jsavinc/arduino_micra_swc_interface/arduino_micra_swc_interface_schematic_schem.png

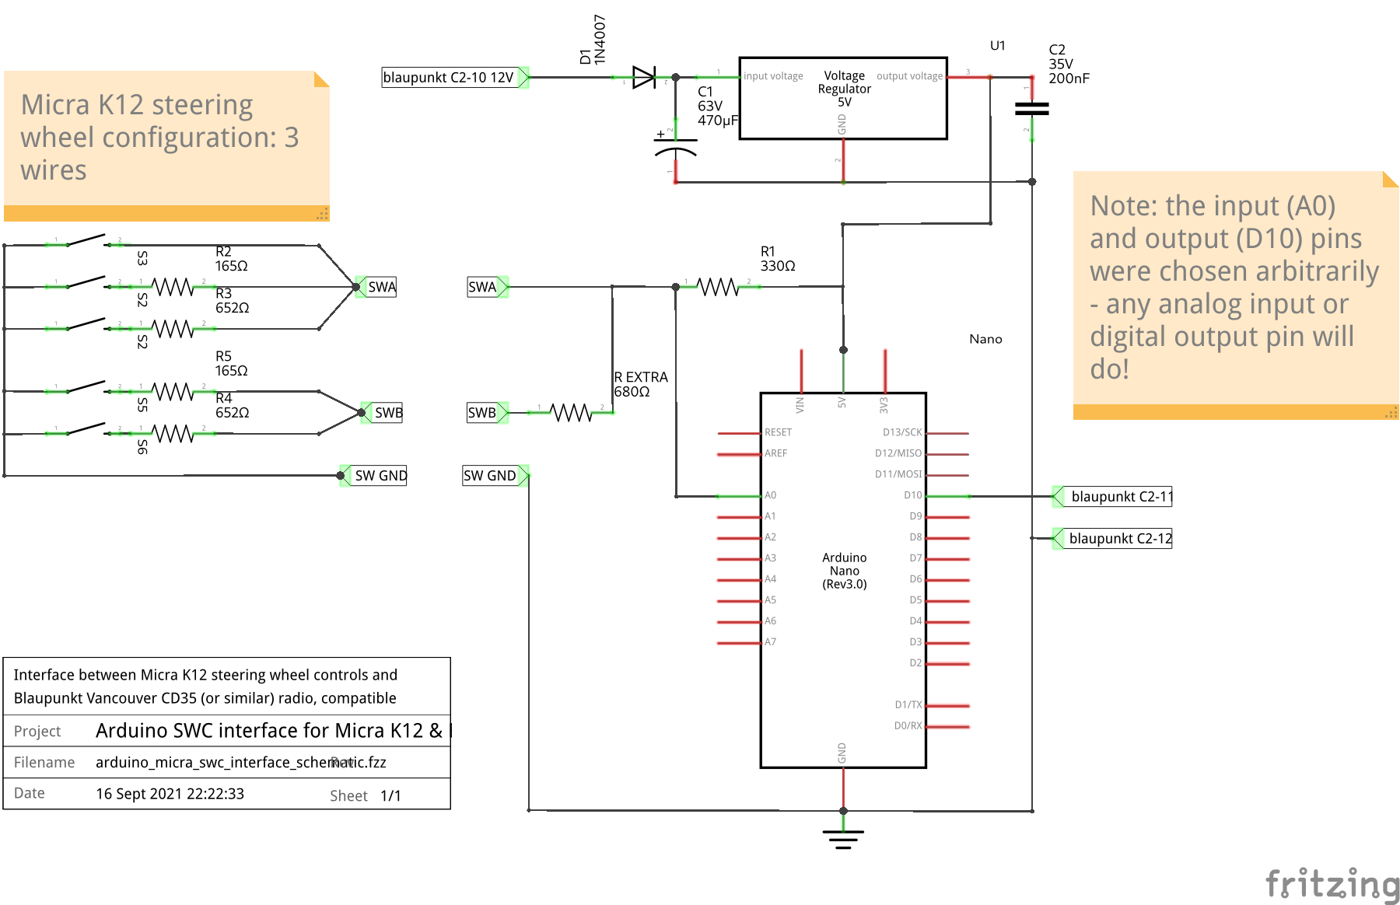
arduino_micra_swc_interface_schematic_schem.png
