jsavinc/arduino_micra_swc_interface/steering wheel - radio diagram micra k12.png

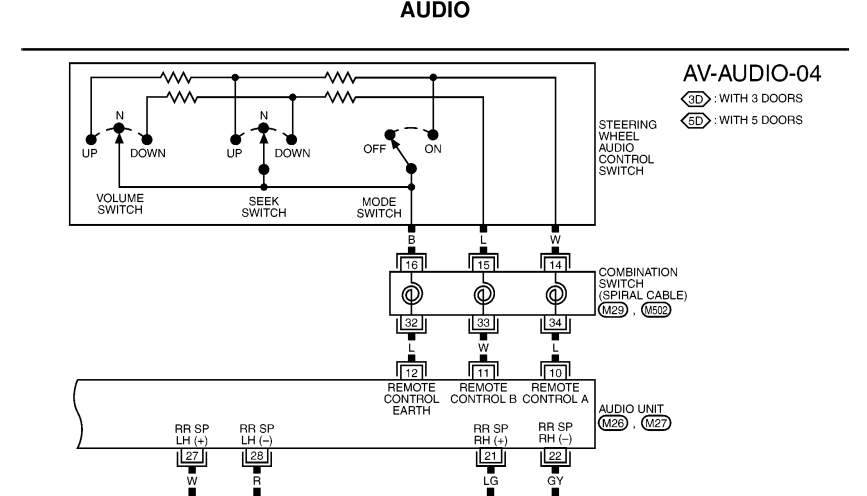
steering wheel - radio diagram micra k12.png
