jsavinc/arduino_micra_swc_interface/resistance_plot_extra_resistor_A.pdf

0 | 50 | 100 | 150

0

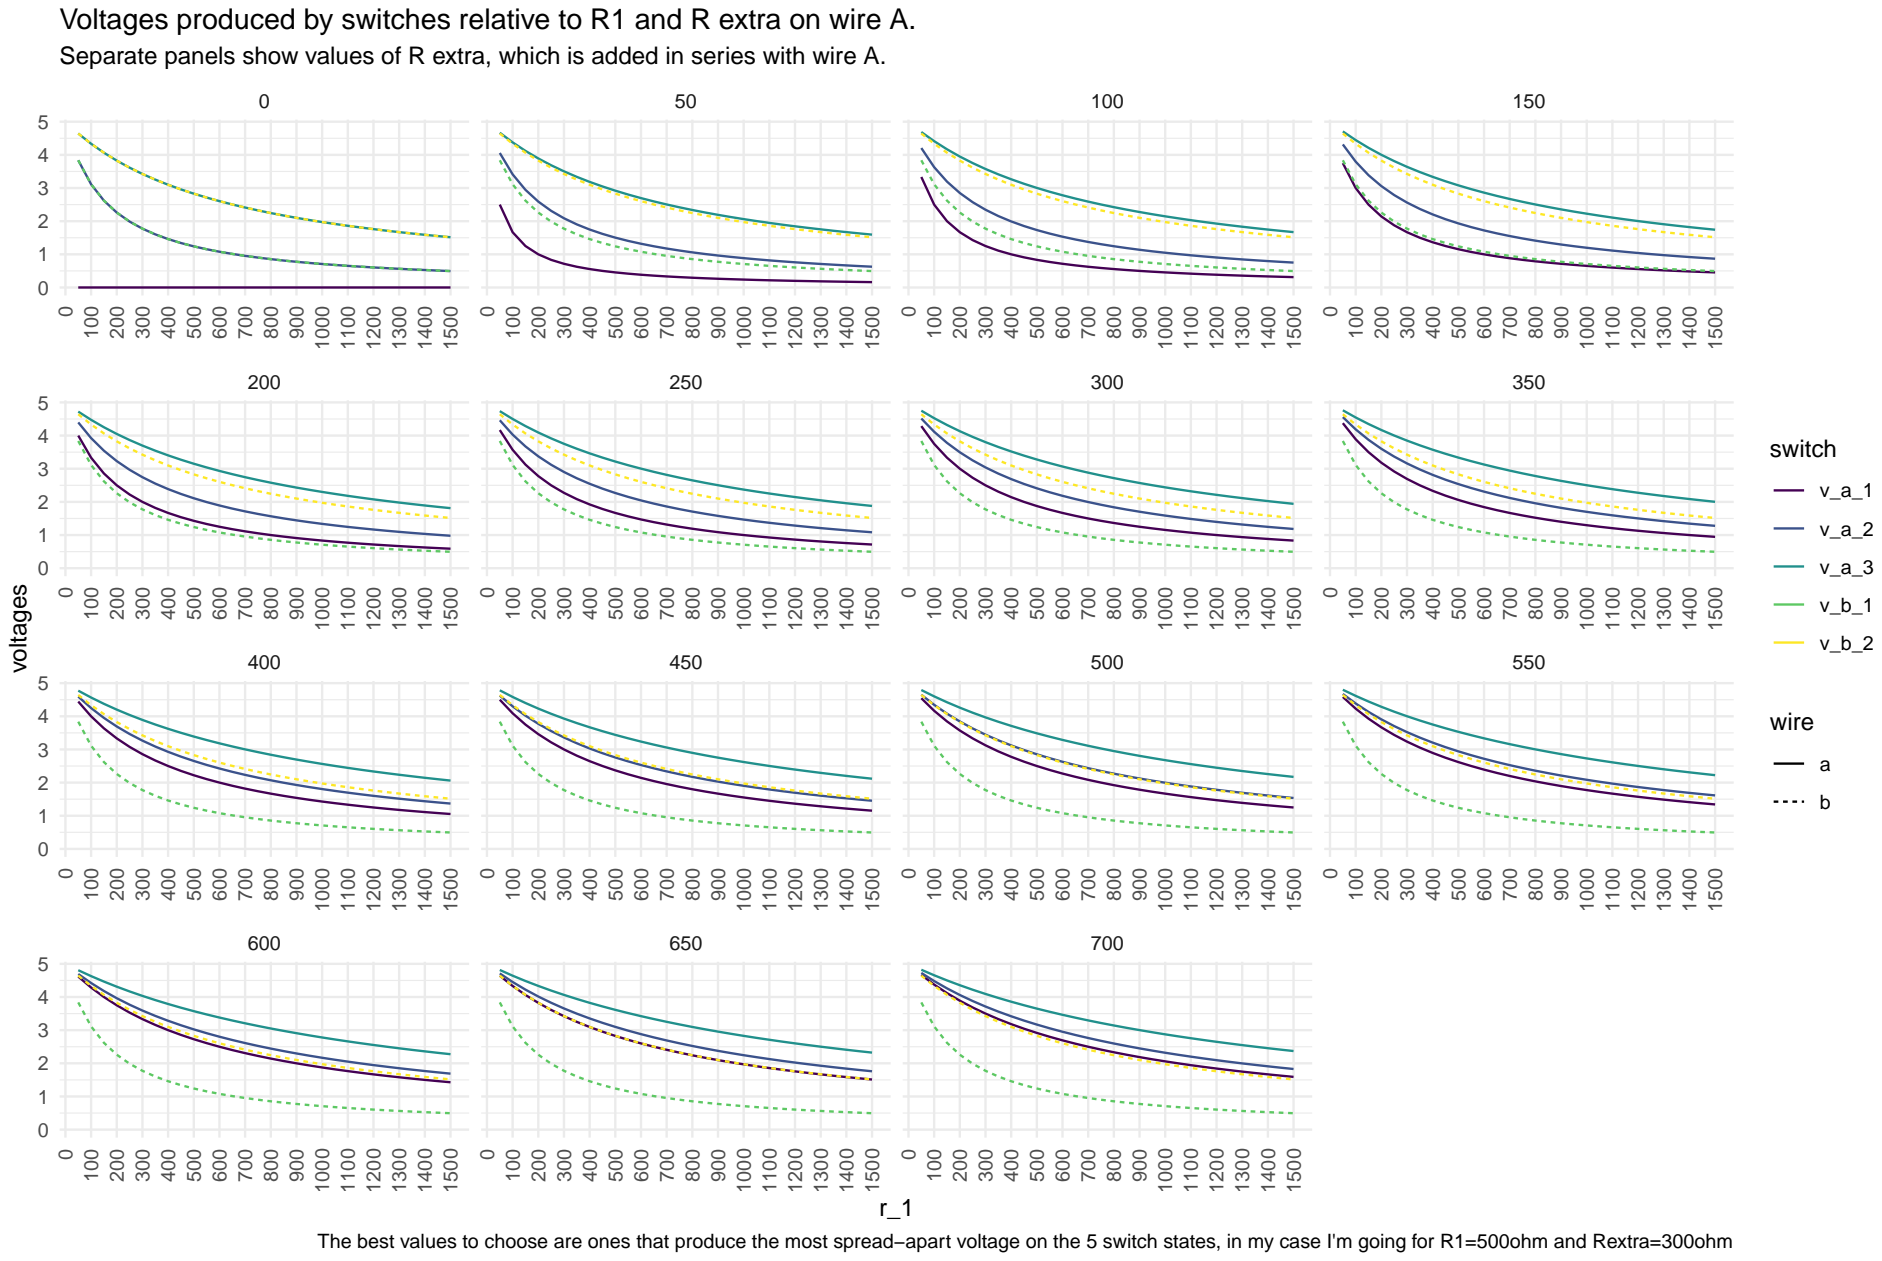
[picture p3: page 1]
voltages; switch; wire

Voltages produced by switches relative to R1 and R extra on wire A.
Separate panels show values of R extra, which is added in series with wire A.

The best values to choose are ones that produce the most spread−apart voltage on the 5 switch states, in my case I'm going for R1=500ohm and Rextra=300ohm
